Kevin-Pal/ECG-Based-Portable-Heart-Rate-Measurement-and-Alarm-Device/Design of 1st Stage/ref/心电放大器设计(更新).pdf

1.）心电信号十分微弱，一般幅度在10uV～4mV，典型值为1mV。

## 2.）频率在0.05～100Hz，主要能量集中在0.25～35Hz。

3.）从人体上输出心电信号时，存在较强的共模干扰。（人体等效为高内阻的信号源）

4.）信号具有近场检测的特点，离开人体表微小的距离，就基本上检测不到信号。

# 心电放大器设计

## 心电信号的主要特点：

5.）干扰特别强。干扰既来自生物体内，如肌电干扰、呼吸干扰等；也来自生物体外

，如工频干扰、信号拾取时因不良接地等引入的其他外来串扰等；

# 心电放大器设计

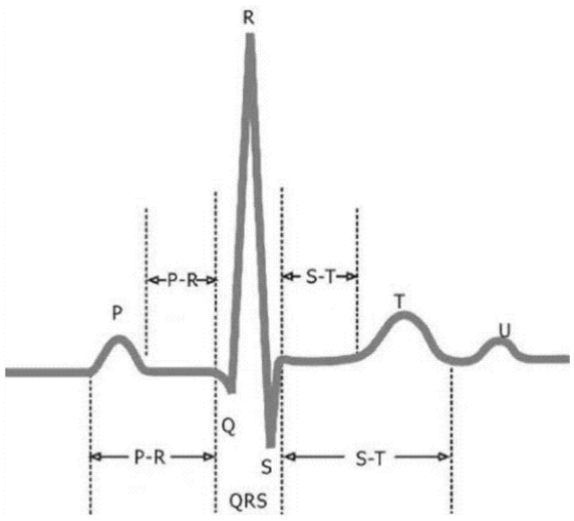
[picture p38: figure]

## 正常的心电信号如图所示：

## 主要的干扰信号

肌电干扰：

肌电干扰主要来源于肌肉活动时，肌肉

细胞的电位变化，一般来源于肌肉的收

缩和颤动，这样的干扰幅值较小，但频
率较高，其频率在5Hz～2000Hz，表现

为不规则快速变化的波形。

# 心电放大器设计

## 主要的干扰信号

工频干扰：

一般还伴随着谐波，在我国使用的市电是50Hz,因此工频干扰也是50Hz的，其谐

波干扰频率一般是50Hz的整数倍。其在时域中表现为整体的极高频，使波形整体图

形模糊，使得信号看起来像是“一整块”，淹没了信号的细节。(一般用均值滤波进

行去噪)

# 心电放大器设计

## 主要的干扰信号

基线漂移：
心电信号的基线漂移主要是由人体呼吸引起的胸廓变化，心电电极的移动引起 ，因为基线漂移与心电信号的ST段较为接近，处理不当，将引起心电信号的ST段信

号失真，造成误诊。常用的去除基线漂移的方法有：小波变换法、中值滤波法、形

态学滤波法、高通滤波法和小波变换法去除基线漂移很有效，但是需要一点的数据

长度，实时性差；中值滤波法在处理基线漂移严重的心电信号时，由于其本身的非 线性特性，容易造成T波变形；高通滤波法选择IIR滤波器时，由于其自身的非线性

相位特性，容易造成波形失真。

# 心电放大器设计

## 设计任务

设计一个心电信号放大电路，能够有效滤除心电信号以外的干扰信号，并能将

微弱的心电信号放大至适合的幅度，以供后续单片机进行集采处理。

## 主要技术指标：

## 1) 输入阻抗： ≥5MΩ 2) 共模抑制比： ≥80dB 3) 通频带： 0.05～100Hz

4）增益：1000倍（放大至单片机可处理范围）

# 心电放大器设计

## 设计指标分析

## 1) 输入阻抗： ≥5MΩ

最好使用JFET输入的运放（输入阻抗极高，输入偏置电流很小，一般为pA-fA级），

使用BJT输入的运放输入阻抗相对小一些，输入偏置电流一般为nA级）

输入端最好构成同向放大器或同向跟随器。

## 可选择的运放：OP07、LF353、TL084、LM358

OP07为BJT输入（一个芯片集成一个运放），输入阻抗： 8M欧-33M欧

工作电压范围：±3V-±18V，也可单电源供电（输入端需要添加参考偏置电压）。

属于精密运放，失调电压小（温漂小），典型值25uV。共模抑制比大于100dB。

# 心电放大器设计

## 设计指标分析

## 1) 输入阻抗： ≥5MΩ

## OP07属于精密运放，输入端噪声相对小。3.5uVp-p(0.1Hz-10Hz)

带宽增益积：500-600KHz 相对较小

压摆率：0.17V/us | 相对较小

适合用作直流，音频等低频小信号精密放大。不能用作高频信号的放大。

适合构成三运放仪表放大器电路、作为前置放大器和有源滤波器！

# 心电放大器设计

## 设计指标分析

## 1) 输入阻抗： ≥5MΩ

LF353属于通用运放（一个芯片集成两个运放），为JFET输入。

输入阻抗很高：1000G欧，失调电压大（温漂大），典型值5mV。

工作电压范围：±5V-±15V，输入噪声比OP07大。

带宽增益积：3-4MHz

## 压摆率：13V/us

适合普通场合的直流，音频等低频小信号放大。可用作中频放大，不能用作高

频信号的放大。适合作为中间级放大器和大信号的有源滤波器！

# 心电放大器设计

## 设计指标分析

## 1) 输入阻抗： ≥5MΩ

TL084属于通用运放（一个芯片集成四个运放），为JFET输入。

输入阻抗很高：1000G欧，失调电压大（温漂大），典型值3mV。

工作电压范围：±3V-±18V，输入噪声比OP07大，比LF353略小。

带宽增益积：3-4MHz

## 压摆率：16V/us

适合普通场合的直流，音频等低频小信号放大。可用作中频放大，不能用作高

频信号的放大。适合作为中间级放大器和大信号的有源滤波器！

# 心电放大器设计

## 设计指标分析

## 1) 输入阻抗： ≥5MΩ

LM358属于通用运放（一个芯片集成两个运放），为BJT输入。

输入阻抗：大约20M欧，失调电压大（温漂大），典型值3mV。

工作电压范围：单电源3V-30V，也可以双电源供电。

输入噪声比OP07大，比LF353略小。

带宽增益积：1MHz

## 压摆率：0.3V/us

适合普通场合的直流，音频等低频小信号放大。不能用作高频信号的放大。

适合作为中间级放大器，比较器和大信号的有源滤波器！

# 心电放大器设计

## 设计指标分析

## 2) 共模抑制比： ≥80dB

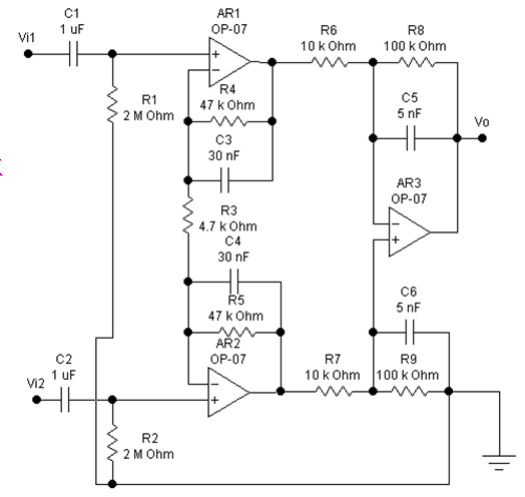
[picture p39: figure]

关键是提高差模增益，降低共模增益，

前级采用仪表放大器（三运放电路）

的结构。
电路中的RC元件尽量对称。

三运放仪器放大器电路如图所示。

电路图中的电容主要作用：构成低通

滤波器。

三运放仪器放大器电路原理图

# 心电放大器设计

## 设计指标分析

## 2) 共模抑制比： ≥80dB

该电路输入电阻大，约为2MΩ，通频带约为（0.2Hz,100Hz），由于高输入阻

抗，电路容易引入50Hz 共模干扰，所以应使电路具有较大CMRR（电路的共模放大

倍数尽可能 小） 电阻R9改为91kΩ固定电阻与20kΩ可变电阻的串联，用于调整，使

电路的共模电压放大倍数尽可能小。
为了使电路的共模电压放大倍数尽可能小，输入端的电容C1、C2和电阻R1、

R2应尽可能一致。

# 心电放大器设计

## 设计指标分析

## 2) 共模抑制比： ≥80dB

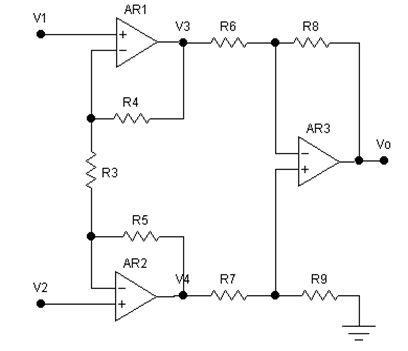
[picture p40: figure]

简化的三运放仪器放大器电路原理图

电路中运放的选择：

## OP07、LF353、TL084、LM358

考虑性能指标哪个更合适？
考虑电路成本和PCB设计布线，哪个比较合适？

# 心电放大器设计

## 设计指标分析

## 2) 共模抑制比： ≥80dB

差模电压增益的计算：

对于AR2，AR1输入端“虚短”

，VNAR1≈V1，VNAR1为AR1反相输入端电压，

AR2、R3、R5等效为反相输入放大器，所以

假设V1≠0、V2接地(V2=0)时，如简化的电路图，对于运放AR1，AR2输入端“

虚短”

，运放AR1、R3、R4等效为同相输入放大器，所以有：

1
3

4

3 | )V
R
R V = (1+ | 1

3

5

4 | V
R

R V = −

# 心电放大器设计

## 设计指标分析

## 2) 共模抑制比： ≥80dB

差模电压增益的计算：

运放AR3构成差分放大器，

8 | 9 | 8
0 | 3 | 4
6 | 7 | 9 | 6
(1 | ) R | R | R V | V | V
R | RR | R
=− ⋅ + | + | ⋅
+

1
3

4

3 | )V
R
R 将 V = (1+ | 代入

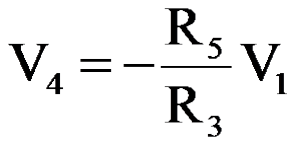
[picture p41: figure]

8 | 4 | 9 | 8 | 5
01 | 1 | 1
6 | 3 | 7 | 9 | 6 | 3
(1 | ) | (1 | ) R | R | R | R R V | V | V
R | R | RR | R | R
=− ⋅ + | + | + | ⋅−
+

将电路图中的电阻数值代入后，可计算出差模电压增益为-210倍。

# 心电放大器设计

## 设计指标分析

## 2) 共模抑制比： ≥80dB

共模电压增益的计算：

同理可得当V1=0、V2≠0时，由V2引起的输出为：

2
3

5

6

6 | 8
7 | 9

9
2
3

4

6

8

o 2 | )V
R

R (1
R

R R
R R

R V
R

R
R
R V | +
+
+
= | +

当电路的输入为共模电压时，有V1=V2=VC，其中VC为共模电压，利用叠加原理，

输出为
C
6 | 7 | 9
6 9 | 7 8
o | o1 | o2 | V

## R (R R )

## R R R R V V V

+

− = | + | =

# 心电放大器设计

## 设计指标分析

## 2) 共模抑制比： ≥80dB

共模电压增益的计算：

电路的共模电压放大倍数为：

## R (R R )

## R R R R

V

V A

6 | 7 | 9
6 9 | 7 8

C

o
VC | +
− = | =

可见，共模电压放大倍数仅与R6、R7、R8、R9有关。若R6R9=R7R8，则共模

电压放大倍数为零。

是否有可能将AVC调得十分接近零呢？

# 心电放大器设计

## 设计指标分析

## 2) 共模抑制比： ≥80dB

灵敏度的计算：

根据以下共模电压放大倍数的灵敏度分析可知，这是十分困难的。

定义电路参数的相对变化率与电路元件值的相对变化率之比为电路参数的灵敏度 。例如，对于本例，共模电压放大倍数AVC关于电阻R6的灵敏度为:

6 9 7 8

7 8

6

V | C
V | C

6

6 | 6
A | vc V | C V | C
R6 | R R R R

R R
dR

dA
A

R

## dRR

dAA S | − = | = | =
7 | 9
6 | 8
6 9 | 7 8

7 9

7

V | C
V | C

7

7 | 7
A | v | cV | CV | C
R7 | R R

R R

## R R R R

R R
d | R
d | A
A

R
d | RR
d | AA S
+

+
−
同样，有 | = | = | = −

# 心电放大器设计

## 设计指标分析

## 2) 共模抑制比： ≥80dB

灵敏度的计算：

因为在设计中要求R6=R7、R8=R9，在实际电路中有R6≈R7、R8≈R9，所以

6 9 7 8

7 9

7

V | C
V | C

7

7 | 7
A | vc V | C V | C
R7 | R R R R

R R
dR

dA
A

R

## dRR

dAA S | − = | = | ≈ −

同理有

6 9 7 8

7 8

8

V | C
V | C

8

8 | 8
A | vc V | C V | C
R8 | R R R R

R R
dR

dA
A

R

## dRR

dAA S | − = | = | = −
6 9 | 7 8

7 9

9

V | C
V | C

9

9 | 9
A | vc V | C V | C
R9 | R R R R

R R
dR

dA
A

R

## dRR

dAA S | − = | = | ≈

# 心电放大器设计

## 设计指标分析

## 2) 共模抑制比： ≥80dB

灵敏度的计算：

这说明，当R6R9 →R7R8时，共模电压放大倍数的灵敏度将趋向无穷大，实际

电路中R6和R7 、R8和R9不可能完全相等，当R6R9 →R7R8时，R6和R7 、R8和R9之

间微小差异，将使共模电压放大倍数AVC发生较大的变化，所以，实际电路的AVC不

会等于零。

# 心电放大器设计

## 设计指标分析

## 2) 共模抑制比： ≥80dB

上述分析还说明，若用一个可变电阻，通过调整可变电阻使实际电路的AVC尽

可能小，则可用可变电阻替代R6、R7 、R8和R9中的任一电阻。本实验电路建议用

可变电阻替代R9。

在用可变电阻替代R9后，对于上图所示的电路，要使共模增益AVC尽可能小，

就应使C1与C2、C3与C4、C5与C6、R1与R2、R6与R7尽可能相等。

# 心电放大器设计

## 设计指标分析

## 2) 共模抑制比： ≥80dB

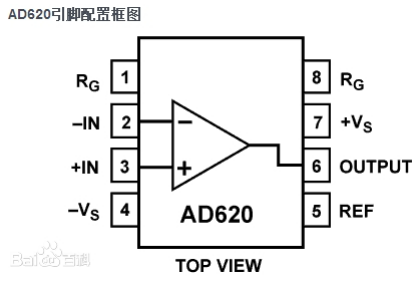
[picture p42: figure]

常用的仪表放大器芯片（集成的三运放电路）

## AD620、INA333、INA128、 INA129等

特点：1.）内部电阻激光工艺匹配精度高，有较高的共模抑制比。

2.）直流精度高，低失调电压(最大50 μV)和低失调漂移。

3.）使用方便，外围元件少，只有一个外部电阻设置总增益。

4. ）可设置输出直流电平。（REF端口）

5.）工作频率相对较低，工作频率升高到一定程度后，共模抑制比明显下降。

# 心电放大器设计

## 设计指标分析

## 2) 共模抑制比： ≥80dB

常用的仪表放大器芯片AD620

AD620具有高精度(最大非线性度40 ppm)、低失调电压(最大50 μV)和低失调漂

移(最大0.6 μV/°C)特性，是电子秤和传感器接口等精密数据采集系统的理想之选。

它还具有低噪声、低输入偏置电流和低功耗特性，使之非常适合ECG和无创血压监

测仪等医疗应用。

其输入级采用Superβeta处理，因此可以实现最大1.0 nA的低输入偏置电流。

## AD620在1 kHz时具有9 nV/√Hz的低输入电压噪声，在0.1 Hz至10 Hz频带内的噪声峰

峰值为0.28μV，输入电流噪声为0.1 pA/ √Hz，因而作为前置放大器使用效果很好。

# 心电放大器设计

## 设计指标分析

## 2) 共模抑制比： ≥80dB

常用的仪表放大器芯片AD620

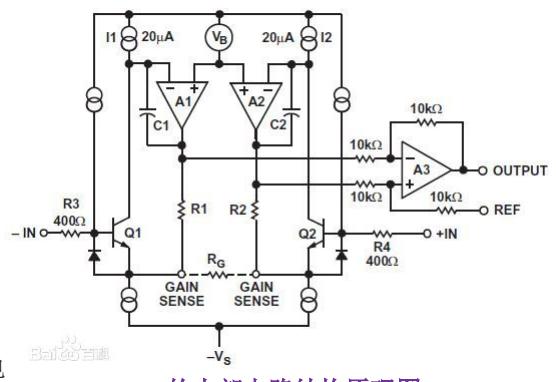
[picture p43: figure]

AD620的内部电路结构原理图

AD620 由传统的三运算放大器发

展而成, 但一些主要性能却优于三

运算放大器构成的仪表放大器。
如电源范围宽(±2. 3～ ±18 V ) ,

设计体积小, 功耗非常低(最大供电

电流仅1. 3 mA ) , 因而适用于低电

压、低功耗的应用场合。

# 心电放大器设计

## 设计指标分析

## 2) 共模抑制比： ≥80dB

常用的仪表放大器芯片AD620

AD620 的单片结构和激光晶体调整, 允许电路元件紧密匹配, 从而保证电路固

有的高性能。AD620 为保护增益控制的高精度, 其输入端的三极管提供简单的差分

双极输入, 并采用β工艺获得更低的输入偏置电流, 通过输入级内部运放的反馈, 保

持输入三极管的集电极电流恒定, 并使输入电压加到外部增益控制电阻 | 上。
AD620 的两个内部增益电阻 | 为24. 7 KΩ , 总增益方程式为：
2 | 49.4 1 | 1 F
G | G

R
G
R | R
=+ | =+

G R

F R

# 心电放大器设计

## 设计指标分析

## 2) 共模抑制比： ≥80dB

常用的仪表放大器芯片AD620的应用： 压力传感器电路

AD620 特别适宜于较高电阻值, 较低电源电压的压力传感器电路设计。左图为3

## .8KΩ、+ 5 V 电源供电的压力传感器电桥。电桥功耗仅为1. 7 mA ,AD620 和AD705

缓冲电压驱动器对信号调节,使总供电电流仅为3. 8 mA , 同时该电路产生的噪声和漂

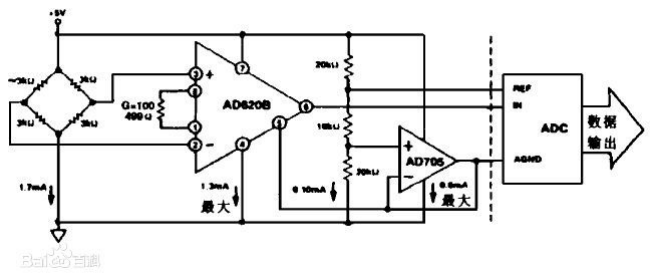
[picture p44: figure]

移也极低。

# 心电放大器设计

## 设计指标分析

## 2) 共模抑制比： ≥80dB

常用的仪表放大器芯片AD620的应用： 心电图监测电路

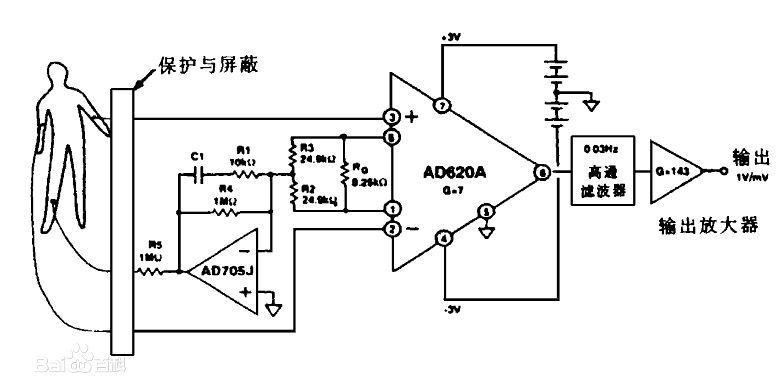
[picture p45: figure]

在心电图监测电路设计中, 信号的源阻抗

极高、器件要求具有便携特点, 这就要求

用低功耗、低供电电压的放大器进行设计
。左图为心电图监测电路中AD620 的应用

。AD620 的低电压噪声改善了动态范围,

使监测电路具有较好的性能, 为了维持图

中驱动环路的稳定性, 应使电容C1 值选择

适当的值。

# 心电放大器设计

## 设计指标分析

## 2) 共模抑制比： ≥80dB

常用的仪表放大器芯片AD620的应用： 精密电压电流转换器

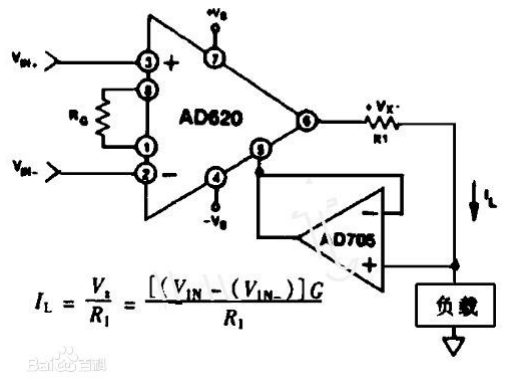
[picture p46: figure]

AD620 与一运放组合可以设计成一个精密电

压电流转换器，通过AD705 对AD620 的参考

端进行缓冲, 使之保持优秀的跟踪性能。

# 心电放大器设计

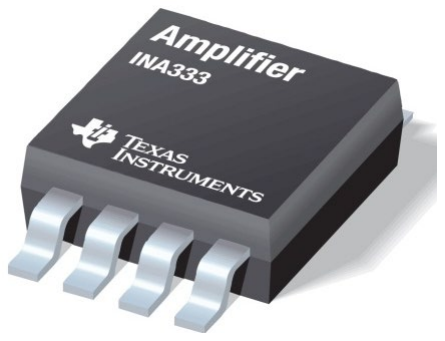
[picture p47: figure]

## 设计指标分析

## 2) 共模抑制比： ≥80dB

常用的仪表放大器芯片INA333

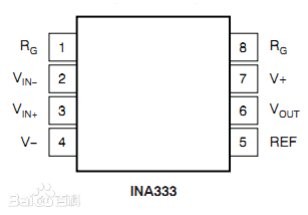
[picture p48: figure]

## 输入失调电压: 25uV (max), G ≥ 100 零点漂移: 0.1 u V/ ° C, G ≥ 100 共模抑制比: 100dB (min), G ≥ 10 输入偏置电流: 200pA (max) 输入电压范围: (V – ) +0.1V to (V+) – 0.1V 输出电压范围: (V – ) +0.05V to (V+) – 0.05V 电源范围：1.8V 至 5.5V

低静态电流：50μA

## 低噪声：50 n V / √ H z ，G ≥ 100

# 心电放大器设计

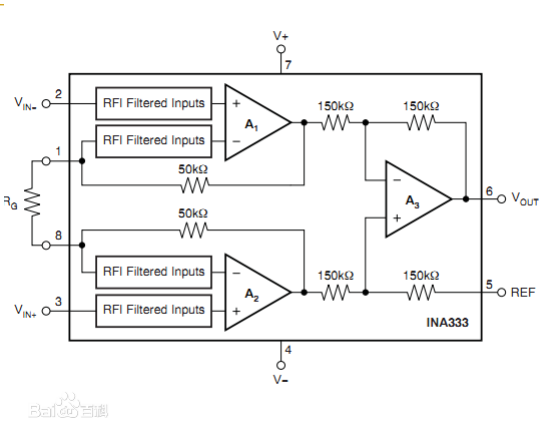
[picture p49: figure]

## 设计指标分析

## 2) 共模抑制比： ≥80dB

常用的仪表放大器芯片INA333

INA333 器件是一款低功耗的精密仪表放大

器，具有出色的精度。该器件采用通用的三

运算放大器设计，并且拥有小巧尺寸和低功

耗特性，非常适合各类便携式 应用。可通
过单个外部电阻在 1 到 1000 范围内设置增

益。INA333 设计为采用符合行业标准的增
益公式： | 2
1 | F
| G

R
G
R

= +

# 心电放大器设计

## 设计指标分析

## 2) 共模抑制比： ≥80dB

常用的仪表放大器芯片INA333

应用范围：
桥式放大器
心电图 (ECG) 放大器
压力传感器
医疗仪表
便携式仪表
衡器
热电偶放大器

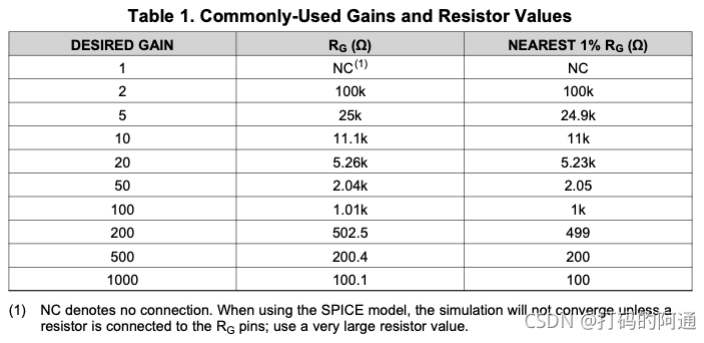
[picture p50: figure]

电阻式温度检测器 (RTD) 传感器放大器
数据采集

# 心电放大器设计

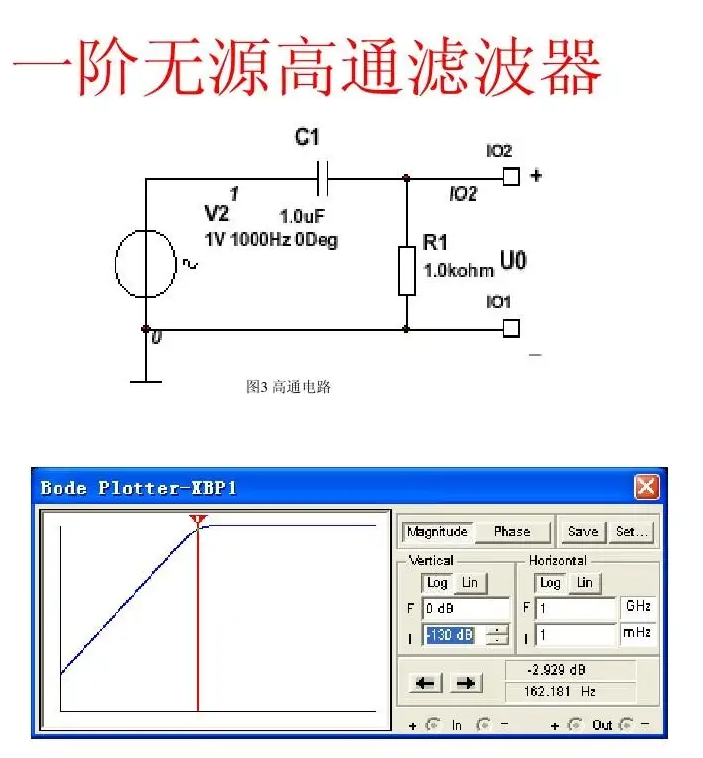
[picture p51: figure]

## 设计指标分析

## 3) 通频带： 0.05～100Hz

电路中采用高通滤波器和低通滤波器

来限制通频带。

高通滤波器可使用无源滤波器：

11

1
2 L f
π RC

=

# 心电放大器设计

## 设计指标分析

## 3) 通频带： 0.05～100Hz

低通滤波器可使用有源滤波器，可以使用MFB或者Sallen_Key结构的有源

滤波器（2阶或者更高阶），也可以在放大器的反馈电阻上并联电容构成简

单的1阶低通滤波器。

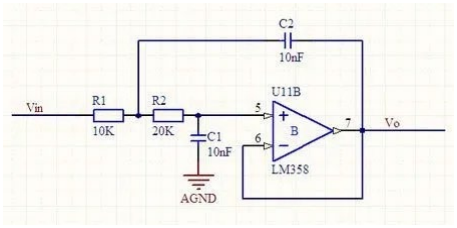
[picture p52: figure]
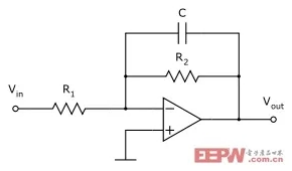
[picture p53: figure]

1阶简单的有源低通滤波器 | Sallen_Key2阶有源低通滤波器

# 心电放大器设计

## 设计指标分析

## 3) 通频带： 0.05～100Hz

2阶基本节MFB滤波器（最少5个外围RC元件）比2阶Sallen_Key基本节滤

波器（最少4个外围RC元件）多一个外围元件，有更低的元件灵敏度，电路更

加稳定，没有高频馈通现象。
2阶Sallen_Key基本节滤波器电路更简单，RC元件参数值的计算方便，可

独立调整通带内的增益和截止频率。

在本次设计的心电放大器中，两种滤波器都可以用。

# 心电放大器设计

## 设计指标分析

## 3) 通频带： 0.05～100Hz

有源RC滤波器的优点：

可以充分利用运放的高开环增益，输入阻抗高，输出阻抗低的优点，滤波器效果

理想，通带内有增益，并且增益可以通过外部电阻进行调节，容易实现滤波器和前后级

电路之间的阻抗匹配。（滤波器工作在低频和中频区）

可借助软件进行滤波器参数的设计，推荐软件：Webench , FilterPro等。

选定使用的运放后，电阻取值范围可以几百欧姆-几十K欧姆（注意小电阻要谨慎使

用，电阻也不要取太大（M欧姆级）），电容取值范围pF-nF级，（电容太大和太小

都不好，注意小电容要谨慎使用，尽量不要使用电解电容），

# 心电放大器设计

## 设计指标分析

## 3) 通频带： 0.05～100Hz

有源RC滤波器的缺点：

（一）带通滤波器Q值较高时，时域上阶跃响应的过冲较大，容易出现不稳定和自激现象

，导致中心频率偏移，谐振曲线出现畸变。

（二）低通和高通滤波器Q值大于0.707时，幅频特性曲线在靠近截至频率处时，会产生

过冲， Q值越大，过冲越大。

（三）受运放供电电源的影响，电源上的噪声会影响输出信号，因此

一般只能做大信号滤波（几十mV以上的信号），不适合小信号滤波。 （四）工作频率受到运放带宽增益积的限制。（一般小于300KHz）

# 心电放大器设计

## 设计指标分析

4）增益：1000倍（放大至单片机可处理范围）

多级放大满足增益条件，合理的配置各级放大器的增益。
前置放大器（仪表放大器）增益不宜过高，一般10倍左右。

高输入阻抗；高共模抑制比；低噪声、低漂移、非线性度小；合适的频

带和动态范围 ，噪声系数小且具有调节方便的特点。

前级增益过高将不利于后续电路对噪声的处理。

本次设计使用三运放电路构成仪表放大器！（建议选择精密运放）

# 心电放大器设计

## 设计指标分析

4）增益：1000倍（放大至单片机可处理范围）

多级放大满足增益条件，合理的配置各级放大器的增益。
中间级放大器可设置固定10倍增益，建议选择精密运放。

可选择反相放大器，输入阻抗相对较低，输入噪声小。（注意前级电路

的输出阻抗）
后级放大器可设置5-20倍增益可调。选择精密运放和通用运放都可以。

可选择同相放大器，输入阻抗相对较高。

# 心电放大器设计

## 心电放大器的结构

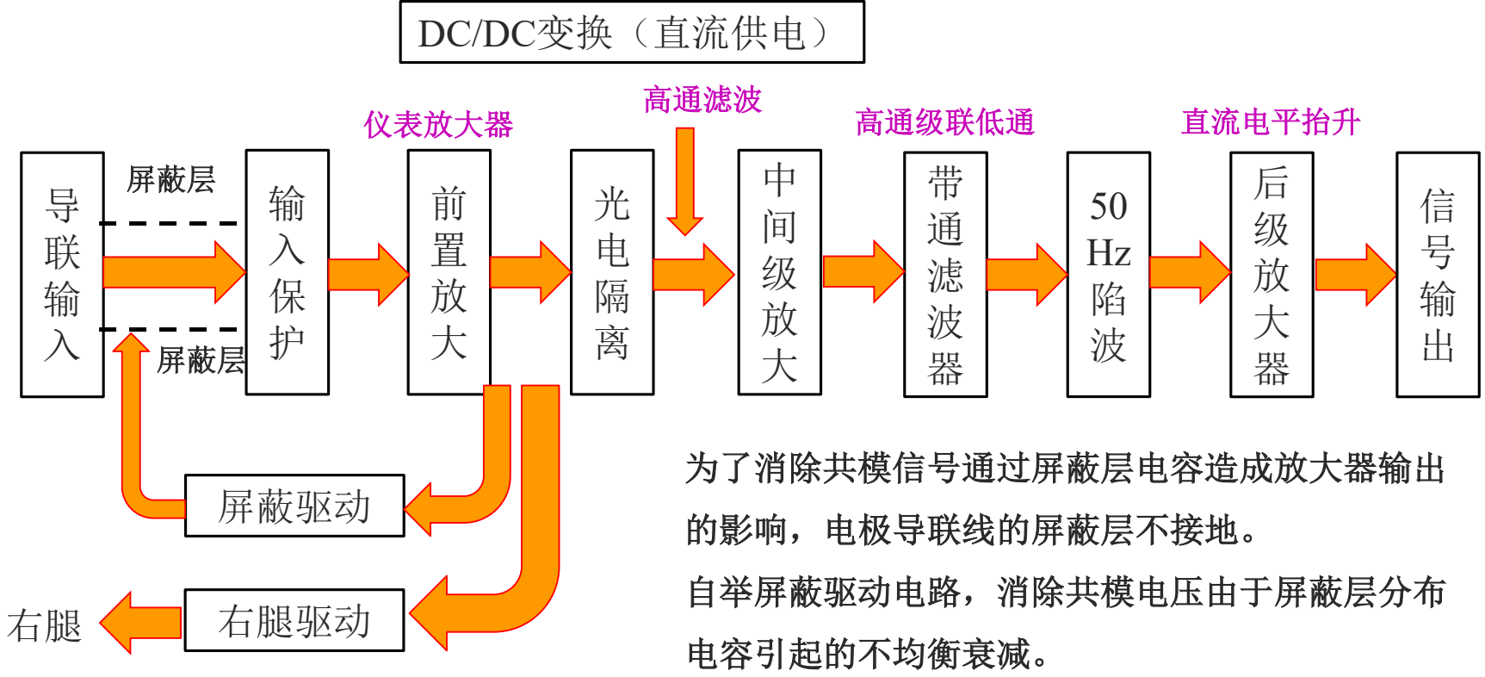
[picture p54: figure]
DC/DC变换（直流供电）; 仪表放大器; 高通级联低通; 屏蔽驱动; 直流电平抬升; 右腿驱动; 屏蔽层; 为了消除共模信号通过屏蔽层电容造成放大器输出; 的影响，电极导联线的屏蔽层不接地。; 自举屏蔽驱动电路，消除共模电压由于屏蔽层分布; 电容引起的不均衡衰减。; 高通滤波

# 心电放大器设计

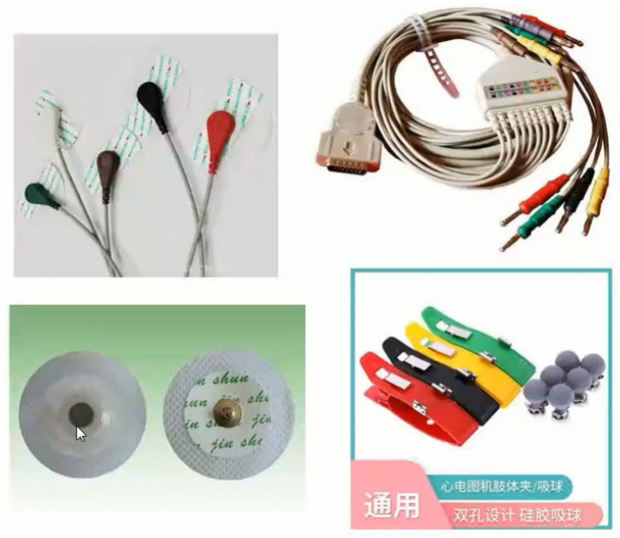
[picture p55: figure]

导联输入

## 心电放大器的结构

将人体中的心电信号耦合

到心电放大器电路中。

# 心电放大器设计

## 心电放大器的结构

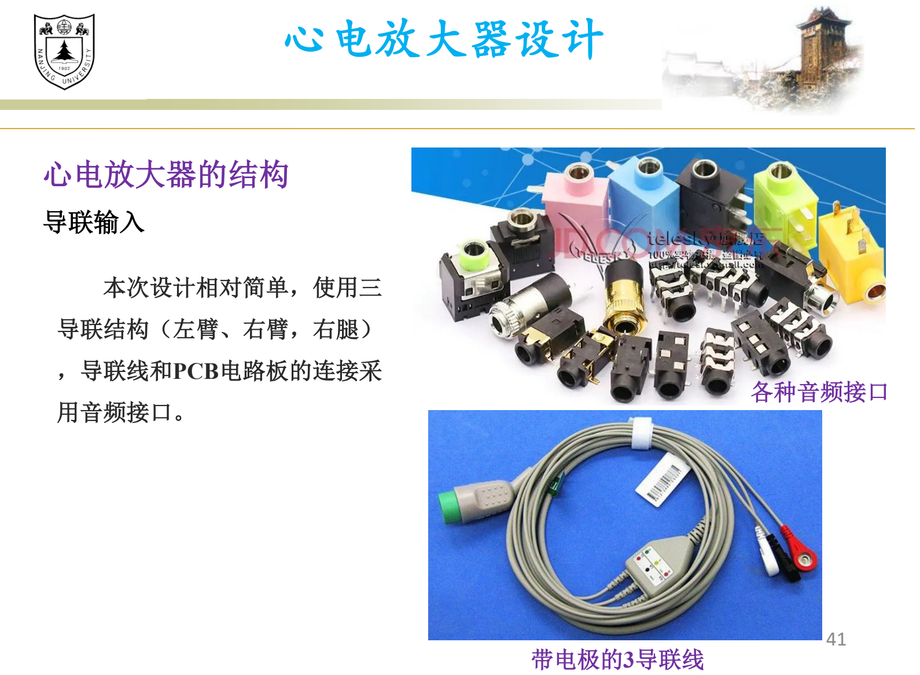
[picture p56: page 41]

导联输入

本次设计相对简单，使用三

导联结构（左臂、右臂，右腿）
，导联线和PCB电路板的连接采

用音频接口。

带电极的3导联线

各种音频接口

# 心电放大器设计

保护电路和屏蔽

## 心电放大器的结构

防止干扰信号输入（大信号电压和电流）使后级放大器饱和，阻塞后级

电路，甚至损坏后级电路。消除地线中的干扰电流，保护人体安全。

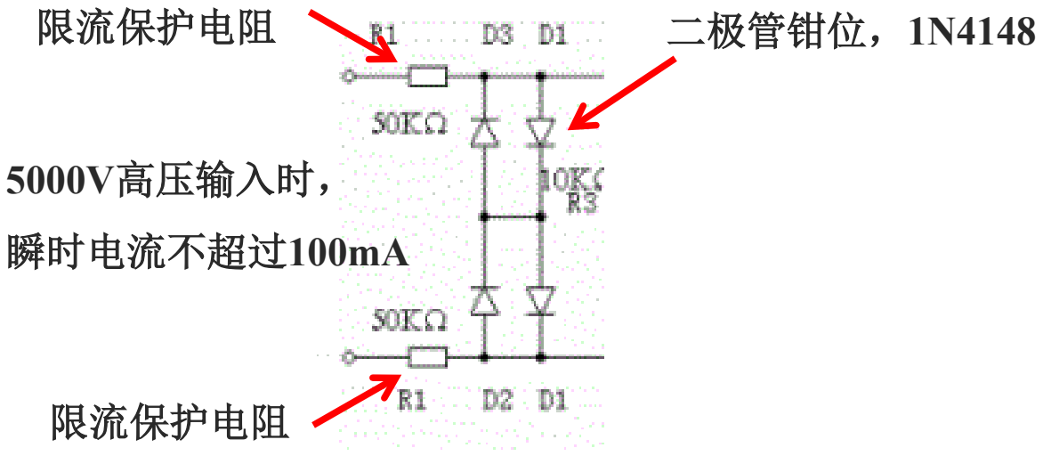
[picture p57: figure]
限流保护电阻; 二极管钳位，1N4148; 5000V高压输入时，; 瞬时电流不超过100mA

限流保护电阻

# 心电放大器设计

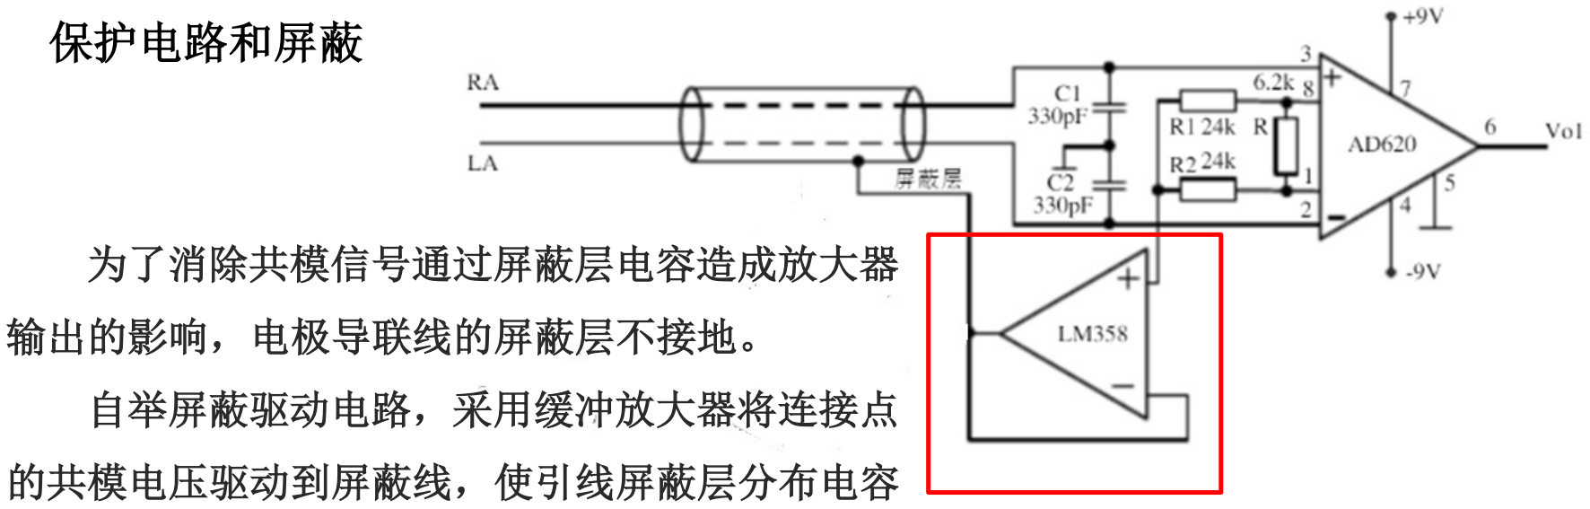
[picture p58: figure]
为了消除共模信号通过屏蔽层电容造成放大器; 输出的影响，电极导联线的屏蔽层不接地。; 自举屏蔽驱动电路，采用缓冲放大器将连接点; 的共模电压驱动到屏蔽线，使引线屏蔽层分布电容

保护电路和屏蔽

## 心电放大器的结构

的两端电压保持相等，消除共模电压由于屏蔽层分

布电容引起的不均衡衰减。

# 心电放大器设计

右腿驱动电路

## 心电放大器的结构

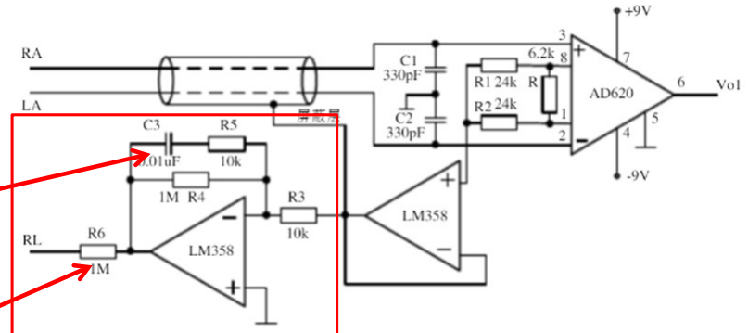
[picture p59: figure]

可以有效的降低共模信号！ | 反相放大，将导联输入中的共模信号反馈到输
| 入端，反相增益越大，对共模信号的抑制就越强！

限流电阻，保护
人体安全

为获得较大增益，
反馈电阻取值较大
，电容C3相位补偿
，提高运放电路的
稳定性。

# 心电放大器设计

右腿驱动电路的工作原理

## 心电放大器的结构

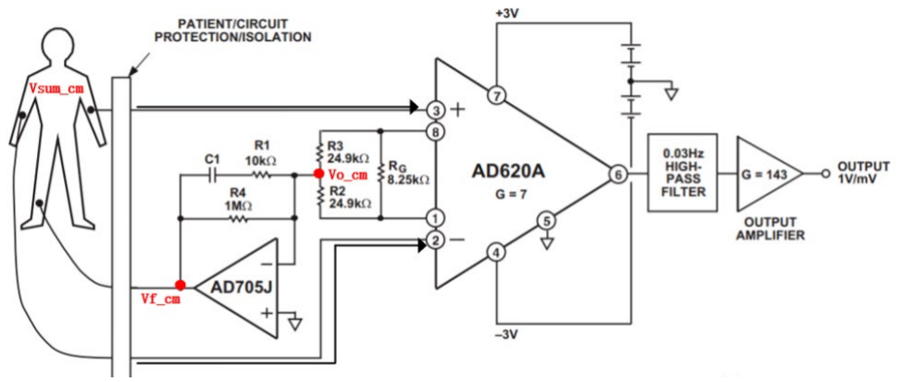
[picture p60: figure]

运放AD705J构成右腿驱动电路，右腿驱动电路的主要作用是提高共模抑制比

，减少50Hz或60Hz的工频干扰。

# 心电放大器设计

右腿驱动电路的工作原理

## 心电放大器的结构

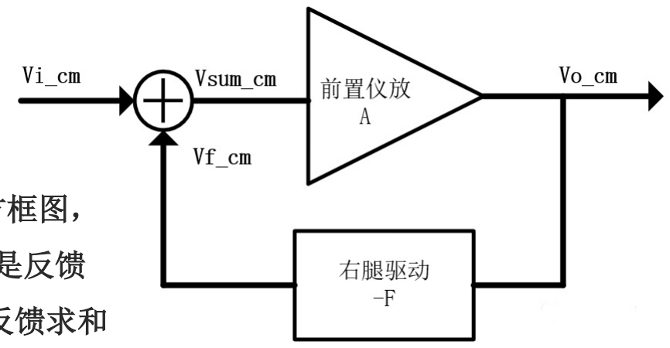
[picture p61: figure]

右腿驱动电路可以简化为如图的方框图，
Vi_cm是输入的共模电压，Vf_cm是反馈

回来的电压，Vsum_cm是输入和反馈求和

后的电压，Vo_cm是输出的电压，前置仪

表放大器对于共模信号而言放大倍数A=1

，右腿驱动电路的放大倍数大约几十倍，

是反向比例放大。

根据上图可以得到系统输入输出关系：

## Vo_cm = Vsum_cm * A = Vsum_cm Vsum_cm = Vi_cm + Vf_cm Vf_cm = -F*Vo_cm 合并上面两个公式： Vo_cm = Vi_cm/ (1 + F)

# 心电放大器设计

右腿驱动电路的工作原理

## 心电放大器的结构

## Vo_cm = Vi_cm/ (1 + F)

由于放大倍数F比较大，因此输入共模电压就被衰减了，Vo_cm会非常小，共

模抑制比是差模增益与共模增益的比值，因此共模抑制比就可以提高。

总结：右腿驱动电路提取出共模电压，对其进行反向放大，再反馈回人体，

人体共模信号叠加这个反向放大的共模信号后就会被抑制。

# 心电放大器设计

前置放大器

## 心电放大器的结构

前置放大器（仪表放大器）增益不宜过高，一般10倍左右。防止电极处产生的极化

直流电压（可能达到300mV），使前置放大器输出饱和。

高输入阻抗；高共模抑制比；低噪声、低漂移、非线性度小；合适的频带和动

态范围 ，噪声系数小且具有调节方便的特点。

前级增益过高也不利于后续电路对噪声的处理。

本次设计前置放大器使用三运放电路构成仪表放大器！（建议选择精密

运放）

# 心电放大器设计

光电隔离

## 心电放大器的结构

在前置放大器和中间级放大器之间使用光耦合器件。（亦称光电隔离器或光

电耦合器，简称光耦）。

光耦器件是以光为媒介来传输电信号的器件，通常把发光器（红外线发光二极 管LED）与受光器（光敏半导体管，光敏电阻等）封装在同一管壳内。当输入端

加电信号时发光器发出光线，受光器接收光线之后就产生光电流，从输出端流出 ，从而实现了“电—光—电”控制。以光为媒介把输入端信号耦合到输出端的光

电耦合器，由于它具有体积小、寿命长、无触点，抗干扰能力强，输出和输入之

间绝缘，单向传输信号等优点，在数字电路上获得广泛的应用。

# 心电放大器设计

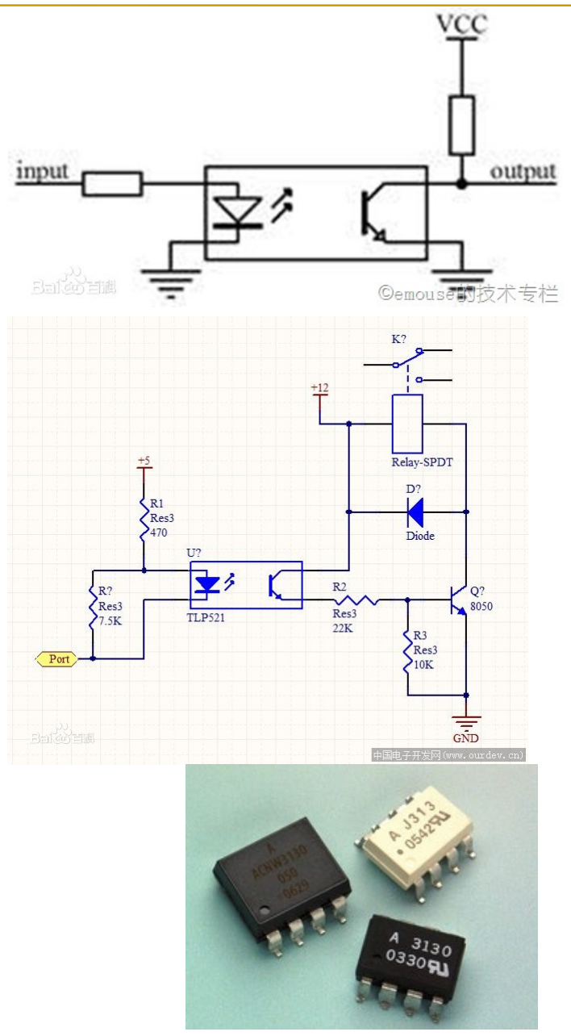
[picture p62: figure]

光电隔离

## 心电放大器的结构

由于光耦合器输入输出间互相隔离，电信号传输

具有单向性等特点，因而具有良好的电绝缘能力和抗

干扰能力。所以，它在长线传输信息中作为终端隔离

元件可以大大提高信噪比。在计算机数字通信及实时

控制中作为信号隔离的接口器件，可以大大提高计算

机工作的可靠性。

光耦合器的输入端属于电流型工作的低阻元件，

因而具有很强的共模抑制能力。

# 心电放大器设计

光电隔离

## 心电放大器的结构

由于光耦合器输入输出间互相隔离，电信号传输具有单向性等特点，因而具有良

好的电绝缘能力和抗干扰能力。所以，它在长线传输信息中作为终端隔离元件可以大

大提高信噪比。在计算机数字通信及实时控制中作为信号隔离的接口器件，可以大大

提高计算机工作的可靠性。

光耦合器的输入端属于电流型工作的低阻元件，因而具有很强的共模抑制能力。

# 心电放大器设计

光电隔离

## 心电放大器的结构

光耦合器的主要优点：

信号单向传输，输入端与输出端完全实现了电气隔离，输出信号对输入端无影响

，抗干扰能力强，工作稳定，无触点，使用寿命长，传输效率高。 光耦合器是70年代发展起来产新型器件，现已广泛用于电气绝缘、电平转换、级

间耦合、驱动电路、开关电路、斩波器、多谐振荡器、信号隔离、级间隔离 、脉冲放 大电路、数字仪表、远距离信号传输、脉冲放大、固态继电器(SSR）、仪器仪表、通

信设备及微机接口中。在单片开关电源中，利用线性光耦合器可构成光耦反馈电路，

通过调节控制端电流来改变占空比，达到精密稳压目的，实现信号接收转移。

# 心电放大器设计

光电隔离

## 心电放大器的结构

光电耦合器分类：

非线性光耦 电流传输特性曲线是非线性的，这类光耦适合于开关信号的传输 ，不适合于传输模拟量。常用的4N系列光耦属于非线性光耦。

线性光耦

电流传输特性曲线接近直线，并且小信号时性能较好，能以线性特性进行隔离 控制。常用的线性光耦是PC817A—C系列。

# 心电放大器设计

光电隔离

## 心电放大器的结构

光电耦合的主要特点：
1.输入和输出端之间绝缘，其绝缘电阻一般都大于10000MΩ，耐压一般可超过1kV

，有的甚至可以达到10kV以上。

2.由于光接收器只能接受光源的信息，反之不能，所以信号从光源单向传输到光接

收器时不会出现反馈现象，其输出信号也不会影响输入端。 3.由于发光器件（砷化镓红外二极管）是阻抗电流驱动性器件，而噪音是一种高内

阻微电流电压信号。因此光电耦合器件的共模抑制比很大，所以，光电耦合器件可

以很好地抑制干扰并消除噪音。

# 心电放大器设计

光电隔离

## 心电放大器的结构

光电耦合的主要特点：
4.容易和逻辑电路配合。

5.响应速度快。光电耦合器件的时间常数通常在毫秒甚至微秒级。

6.无触点、寿命长、体积小、耐冲击。

在心电放大器中使用光耦器件，可实现小信号的单向传输，防止后级放大器的

输出信号和干扰信号影响前级小信号放大。
有时候用微处理器（FPGA器件）驱动控制小功率信号器件（电路）+光电隔离

+驱动大功率器件，保护前端的微处理器和小功率信号器件（电路），防止被反向

的浪涌电压和电流造成损坏。

# 心电放大器设计

中间级放大

## 心电放大器的结构

中间级放大器可设置固定增益（比如10倍左右），建议选择精密运放。

可选择反相放大器，输入阻抗相对较低，输入噪声小。（注意前级电路的输

出阻抗）

# 心电放大器设计

带通滤波器

## 心电放大器的结构

可使用无源高通滤波器+有源低通滤波器串联。

低通滤波器的截止频率选择在100Hz左右，可以使用MFB或者Sallen_Key结构的

有源低通滤波器（一般2阶就可以了，下降速度更快则需要2阶以上）。

滤波器的运放可以选择OP07也可以使用通用运放。

# 心电放大器设计

## 50Hz陷波

## 心电放大器的结构

在心电放大器前端输入和中间耦合的众多噪声中，50Hz的工频干扰尤为严重

，因此在电路设计时可设计50Hz的陷波器，进一步消除工频信号干扰。但由于心

电信号频率在0.05～100Hz，陷波器的加入会使得50Hz及其附近频率处的能量衰

减，心电信号会有一定程度地失真。

# 心电放大器设计

## 50Hz陷波

## 心电放大器的结构

双T网络陷波电路，又称为带阻滤波器，用于抑制或衰减某一频率段的信号

，而该频率段外的所有信号可以通过。典型的RC双T网络，又RC低通滤波器和

RC高通滤波器并联而成。低通滤波器的截止频率为 | ，高通滤波器的截止频率
为 | ，满足条件 | 时构成带阻滤波器。当输入信号通过电路时，频率低于
的信号均可以从低通滤波器通过；频率高于 | 的信号均可以从高通滤波器通过
；频率范围在 | 内的信号被衰减或阻断。

1 f

2 f | 1 | 2 f | f <
1 f | 2 f
1 | 2 f | f | f < | <

# 心电放大器设计

## 50Hz陷波

## 心电放大器的结构

无源双T网络陷波电路，元件参数满足关系：

1 | 2 C | C | C = | = | 3 C | C = 2
1 | 2 R | R | R = | = | 3 R | R = | /2

0

1
RC 带阻中心频率 ω =
品质因数 ⁴ 2
RC β = | 0 | 1
2 | 4
Q | ω
β = | =

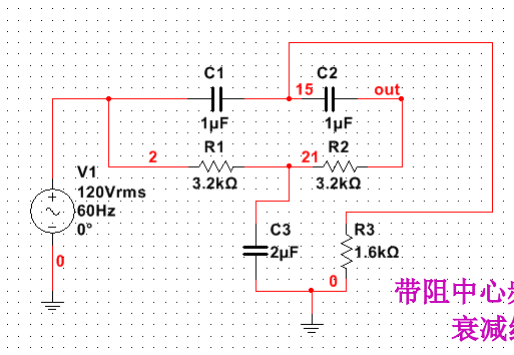
[picture p63: figure]
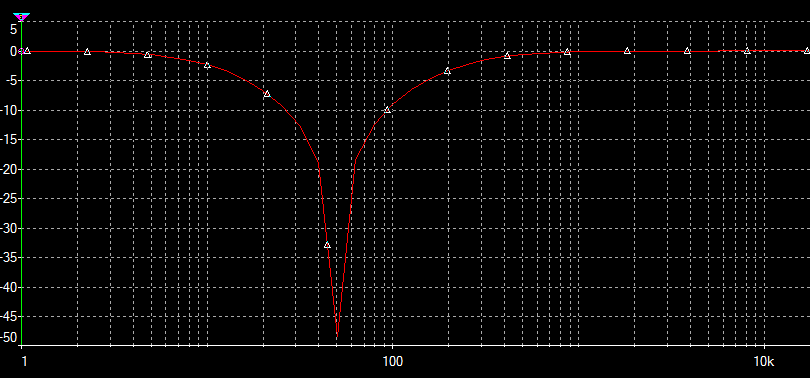
[picture p64: figure]

无源双T网络陷波电路 | 无源双T网络陷波电路的频率响应

带阻中心频率约50Hz

### 衰减约50dB

# 心电放大器设计

## 50Hz陷波

## 心电放大器的结构

无源双T网络陷波电路，输入阻抗较小，输出阻抗较大，容易受到前后级电

路的影响，Q值较低，衰减带宽较宽，对阻带中心频率两侧的信号影响较大。

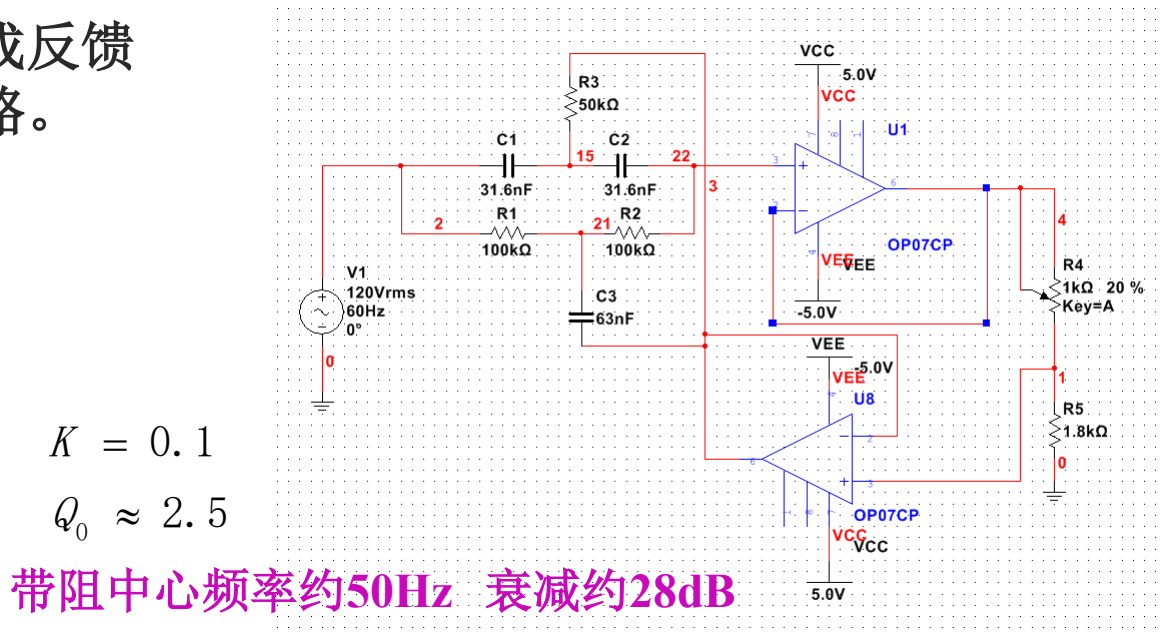
[picture p65: figure]
带阻中心频率约50Hz 衰减约28dB

无源双T网络陷波电路加上运放构成反馈
，组成性能较好的有源双T陷波电路。

有源双T网络陷波电路

0 Q ≈ 2.5

K = 0.1

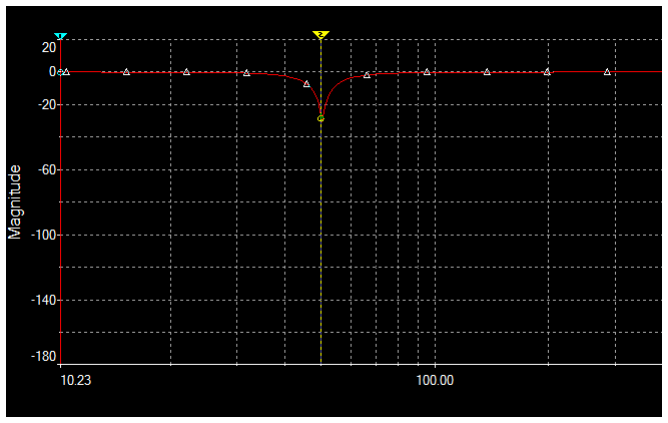
[picture p66: figure]

有源双T网络陷波电路的频率响应

# 心电放大器设计

## 50Hz陷波

## 心电放大器的结构

有源双T网络陷波电路，由两个运放和双T陷波网络组成，引入负反馈改善选

频作用，运放U1提供反馈回路的增益，同时对双T陷波网络起到隔离作用。

两个反馈电阻的 取值， | ， | 系数K决定阻带宽度。K越

大，阻带宽度越窄，品质因素Q值越高，陷波特性越好，但同时使得电路的稳定

性变差；反之， K越小，阻带宽度越宽，品质因素Q值越低，陷波特性越差，电

路的稳定性越好。

4 | (1 | ) F R | KR = | − | 5 | F R | KR =

0

1
2

f

π RC = | 0

1
4(1 | ) Q
K = | − | 设计时要求电阻R远大于RF

仿真时观测到，随着K越大，品质因素Q增加，陷波宽度越窄，但是陷波深度

也变小。因此需要合理的选择K值，在电路稳定性、陷波宽带和陷波深度之间

取得平衡。

# 心电放大器设计

后级放大器

## 心电放大器的结构

对心电信号进行进一步放大，使总增益满足设计要求（1000倍）。后级放

大器可设置5-20倍增益可调。选择精密运放和通用运放都可以。

可选择同相放大器，输入阻抗相对较高。

注意点：在本设计中心电信号最终输出给单片机进行ADC采样后续处理，而单

片机的ADC端口输入电压范围为0-3.3V（单极性） ，因此在设计后级电压放大

器时需合理选择放大倍数。

# 心电放大器设计

后级放大器

## 心电放大器的结构

后级放大器的增益不能太小，否则心电放大器的总增益太小，会使得输入单 片机ADC采样的波形幅度不够，单片机ADC采集数据的误差变大；也不宜过大，

否则会使得输入单片机采样的波形幅度超出单片机的ADC端口输入最大电压3.3V

，造成较大的采样误差，甚至损坏单片机的ADC输入端口。

后级放大器中需要加入电压抬升电路
单片机ADC采样端口的输入电压范围一般为0-3.3V，而心电信号有负电压，

因此需要将心电信号加上直流偏置，转换为电压范围在0-3.3V之间的单极性信号

，最后输出到单片机的ADC采样端口进行后续处理。

# 心电放大器设计

后级放大器

## 心电放大器的结构

电压抬升电路设计
可使用单电源供电的运放（LM358或者OP07用单电源供电），在输入加上

直流偏置电压，使运放电路输出的直流电平在 3.3/2=1.65V的位置。

也可以使用加法器电路，将一路直流偏置电压加到输入端，最后和输入交流

信号一起放大后输出。

# 心电放大器设计

## 心电放大器的结构

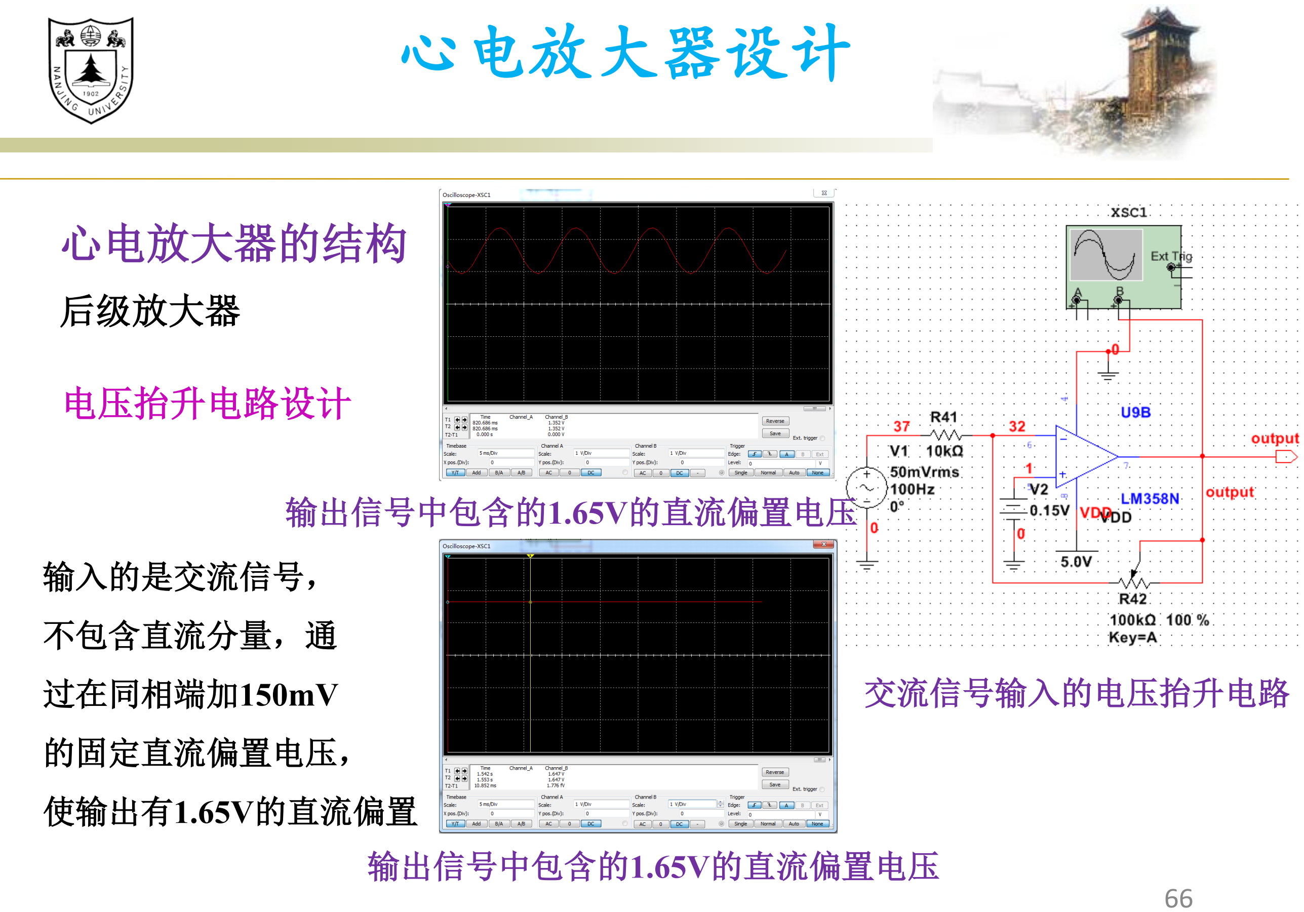
[picture p67: page 66]

后级放大器

电压抬升电路设计

交流信号输入的电压抬升电路

输出信号中包含的1.65V的直流偏置电压

输出信号中包含的1.65V的直流偏置电压

输入的是交流信号，

不包含直流分量，通
过在同相端加150mV

的固定直流偏置电压，
使输出有1.65V的直流偏置

# 心电放大器设计

## 心电放大器的结构

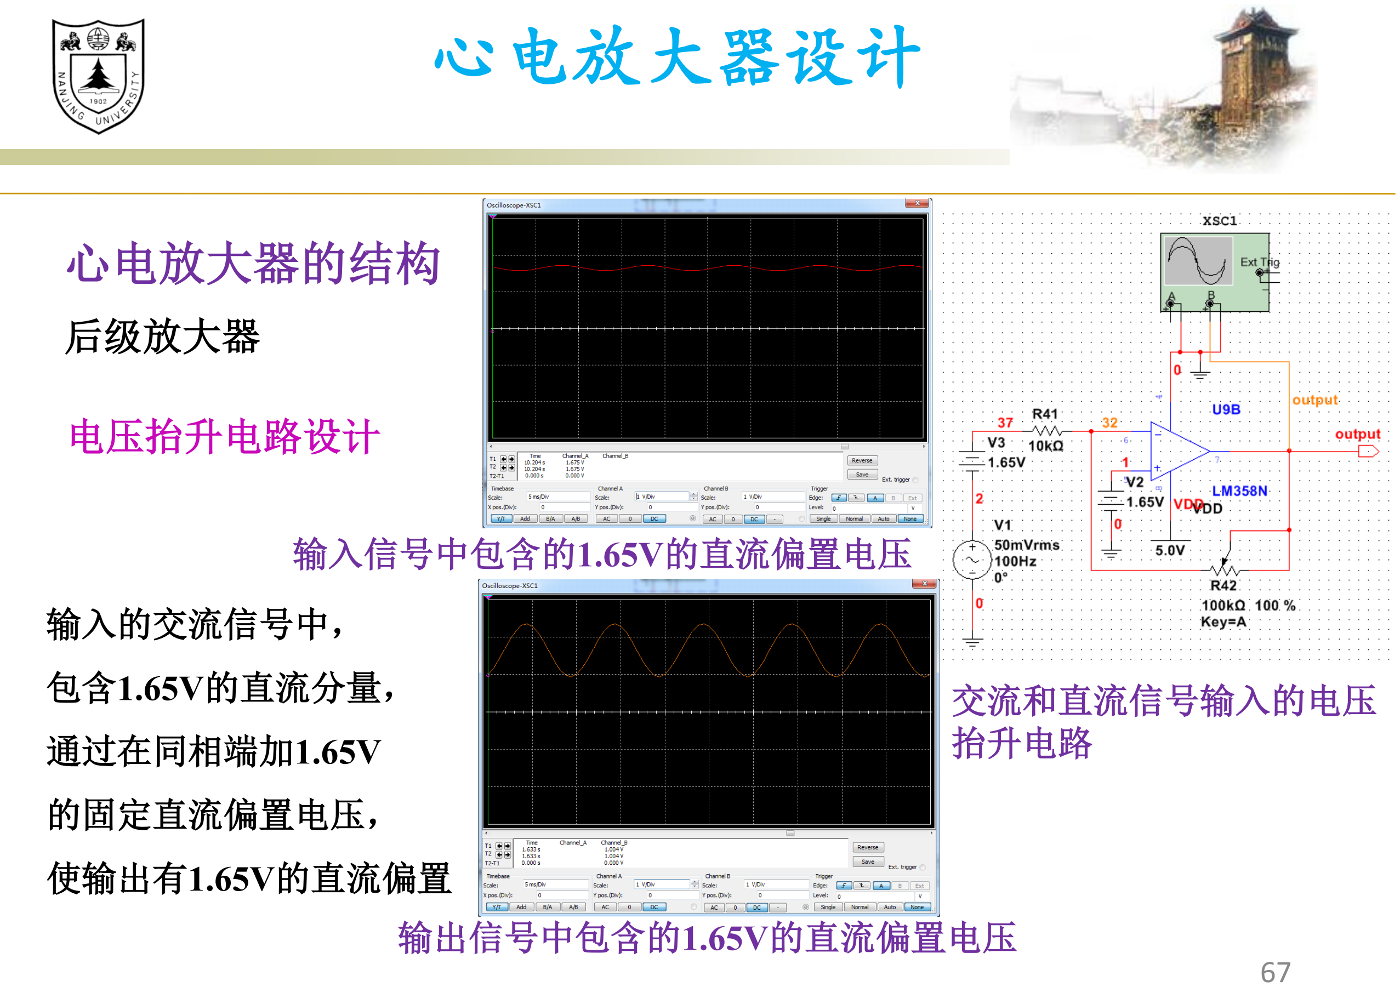
[picture p68: page 67]

后级放大器

电压抬升电路设计

输入信号中包含的1.65V的直流偏置电压

输出信号中包含的1.65V的直流偏置电压

输入的交流信号中，
包含1.65V的直流分量，

通过在同相端加1.65V

的固定直流偏置电压，
使输出有1.65V的直流偏置

交流和直流信号输入的电压
抬升电路

# 心电放大器设计

运放电路可选择双电源供电（电路输入端不需要提供直流偏置，

输出动态范围大）

也可以选择单电源供电 （电路输入端需要提供直流偏置，

输出动态范围小一些，但只需一路正电源）

## 心电放大器的直流电源

电源去耦：在靠近运放的正负电源附近，接0.1uF的无极性电容进行高频去耦（也

可以再并联1个10uF的电解电容进行低频去耦）

在外部的正负直流电源输入端旁边接入10uF的电解电容进行低频去耦。

# 心电放大器设计

有条件的可使用分级去耦的供电方式：

小信号电路和大信号电路的直流电源分级去耦，减小电源馈线上的反馈和

干扰，减小各级电路之间的相互干扰，提高电路输出信号的信噪比，提高电路抗

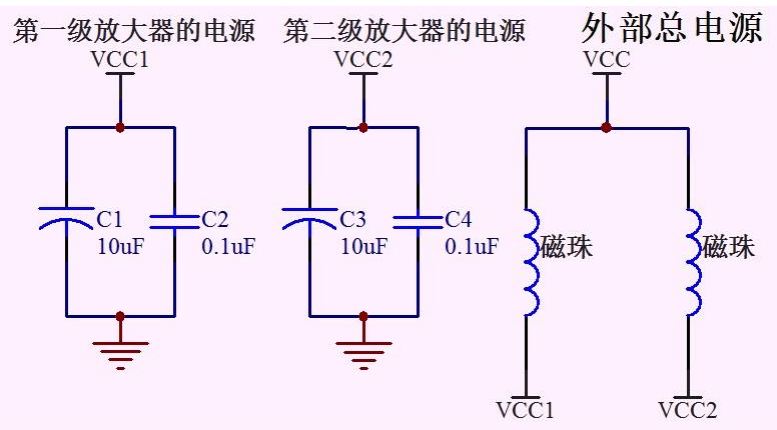
[picture p69: figure]

噪声性能。

## 心电放大器的直流电源

前置放大器的电源
中间级放大器的电源
有源滤波器的电源
后级放大器的电源

可以分级去耦供电
