Kevin-Pal/ECG-Based-Portable-Heart-Rate-Measurement-and-Alarm-Device/Design of 2nd Stage/project/project file/原始数据/IMG_9389.JPG

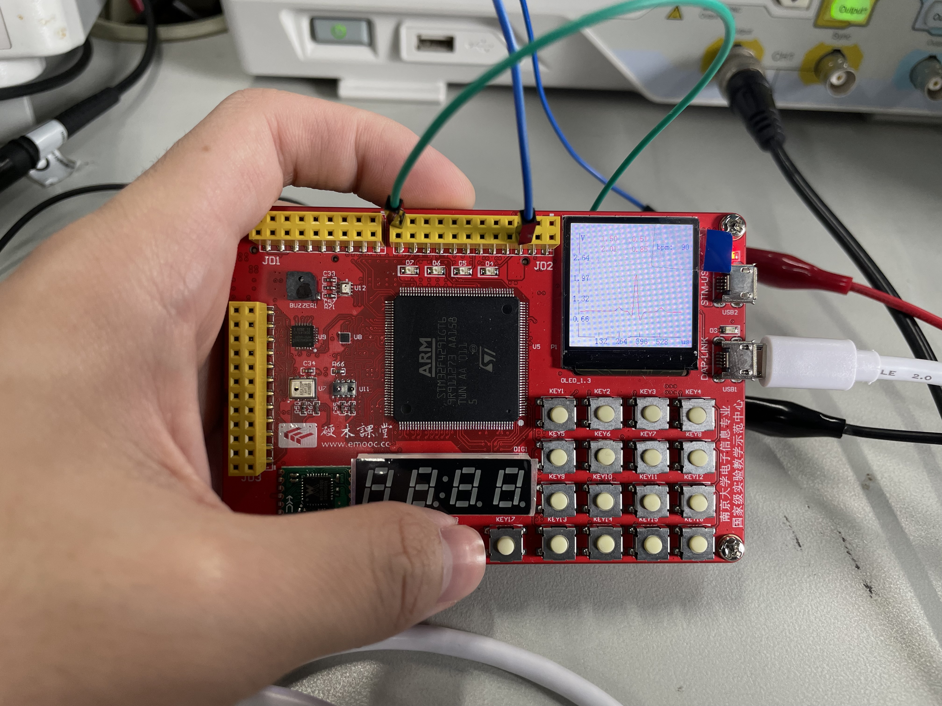
Design of 2nd Stage/project/project file/原始数据/IMG_9389.JPG
