Kevin-Pal/ECG-Based-Portable-Heart-Rate-Measurement-and-Alarm-Device/Design of 1st Stage/ref/实验室提供元器件.xlsx

元器件名称 | 规格 | 备注
常规电阻/电容 | 贴片0805 | 1%误差
常规电阻/电容 | 直插 | 1%误差
精密电阻（误差0.1%） | 贴片0805 | 10K、20K、30K、51K、100K
 | 直插 | 10K、20K、30K、50K、100K
TL084CDR | SOP14 | 四通道14引脚运算放大器（3MHz）
LM358D | SOP8 | 双运算放大器8引脚（1.1MHz）
OP07CDR | SOP8 | 单运算放大器（600KHz）
TL084CN | DIP14 | 四通道14引脚运算放大器（4MHz）
LM358P | DIP8 | 双运算放大器八引脚（1.1MHZ）
LF353P | DIP8 | 双运算放大器八引脚（3MHZ）
OP07CP | DIP8 | 单运算放大器（600KHz）
IC座 | 8脚
 | 14脚
3296电位器 | 直插 | 1K、5K、10K、20K、50K
音频插座 | 贴片/直插
测试环
跳线帽
单排针
 |  | 0
