Kevin-Pal/ECG-Based-Portable-Heart-Rate-Measurement-and-Alarm-Device/Design of 2nd Stage/project/project file/STM32F429-20210111(1).pdf

# AD+DA+SPI+UART+IIC+TIMER

数码管&按键 | WIFI

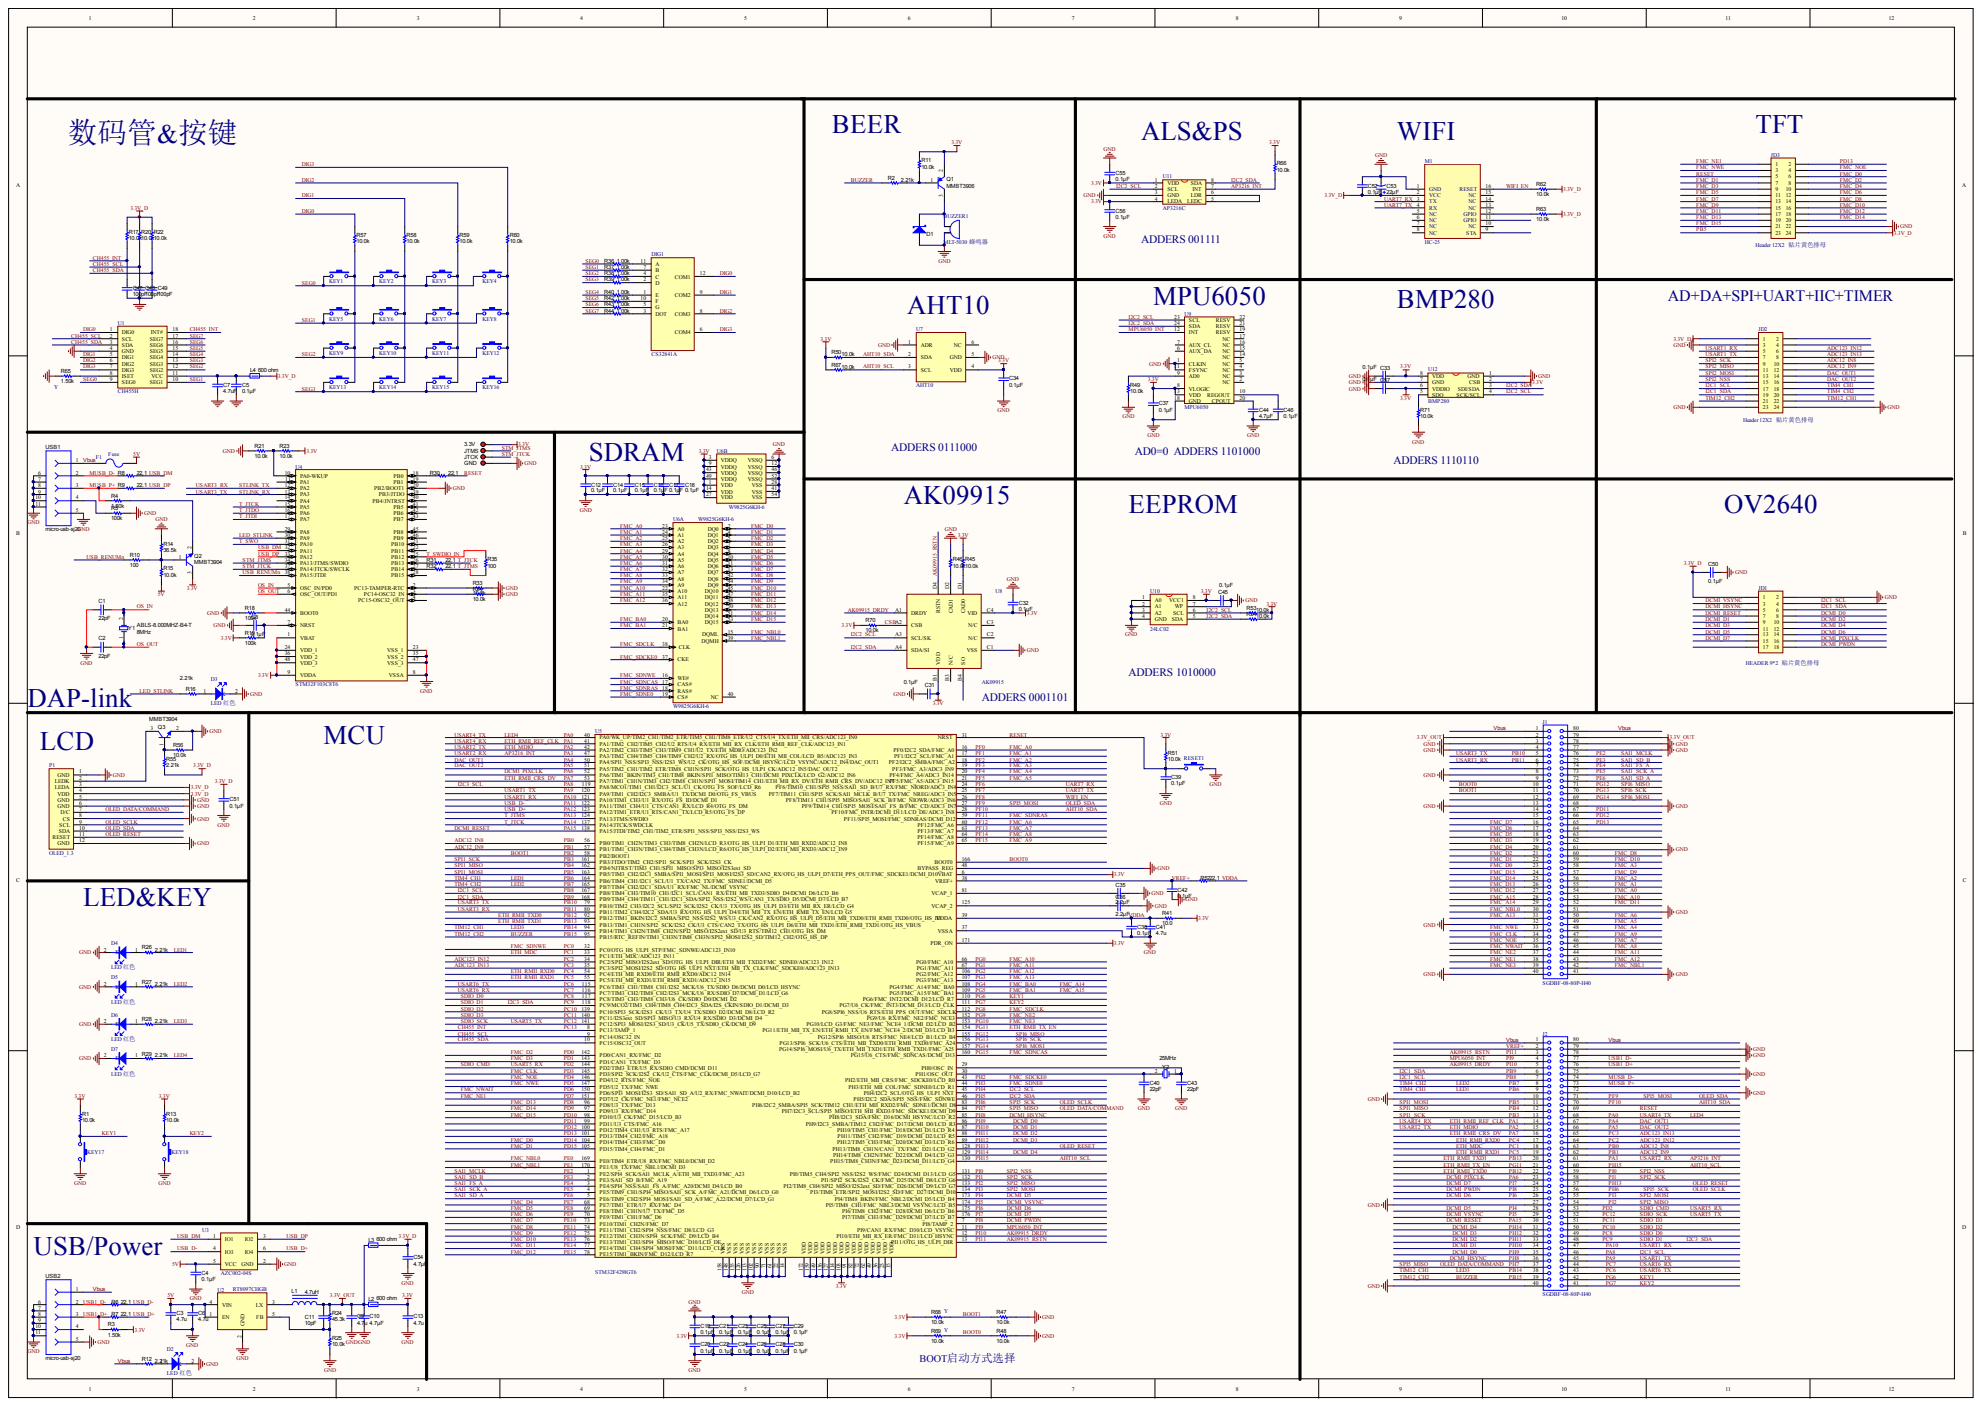
[picture p88: page 1]
