Kevin-Pal/ECG-Based-Portable-Heart-Rate-Measurement-and-Alarm-Device/Design of 2nd Stage/ref/STM32参考资料/4-STM32F429-开发板原理图.pdf

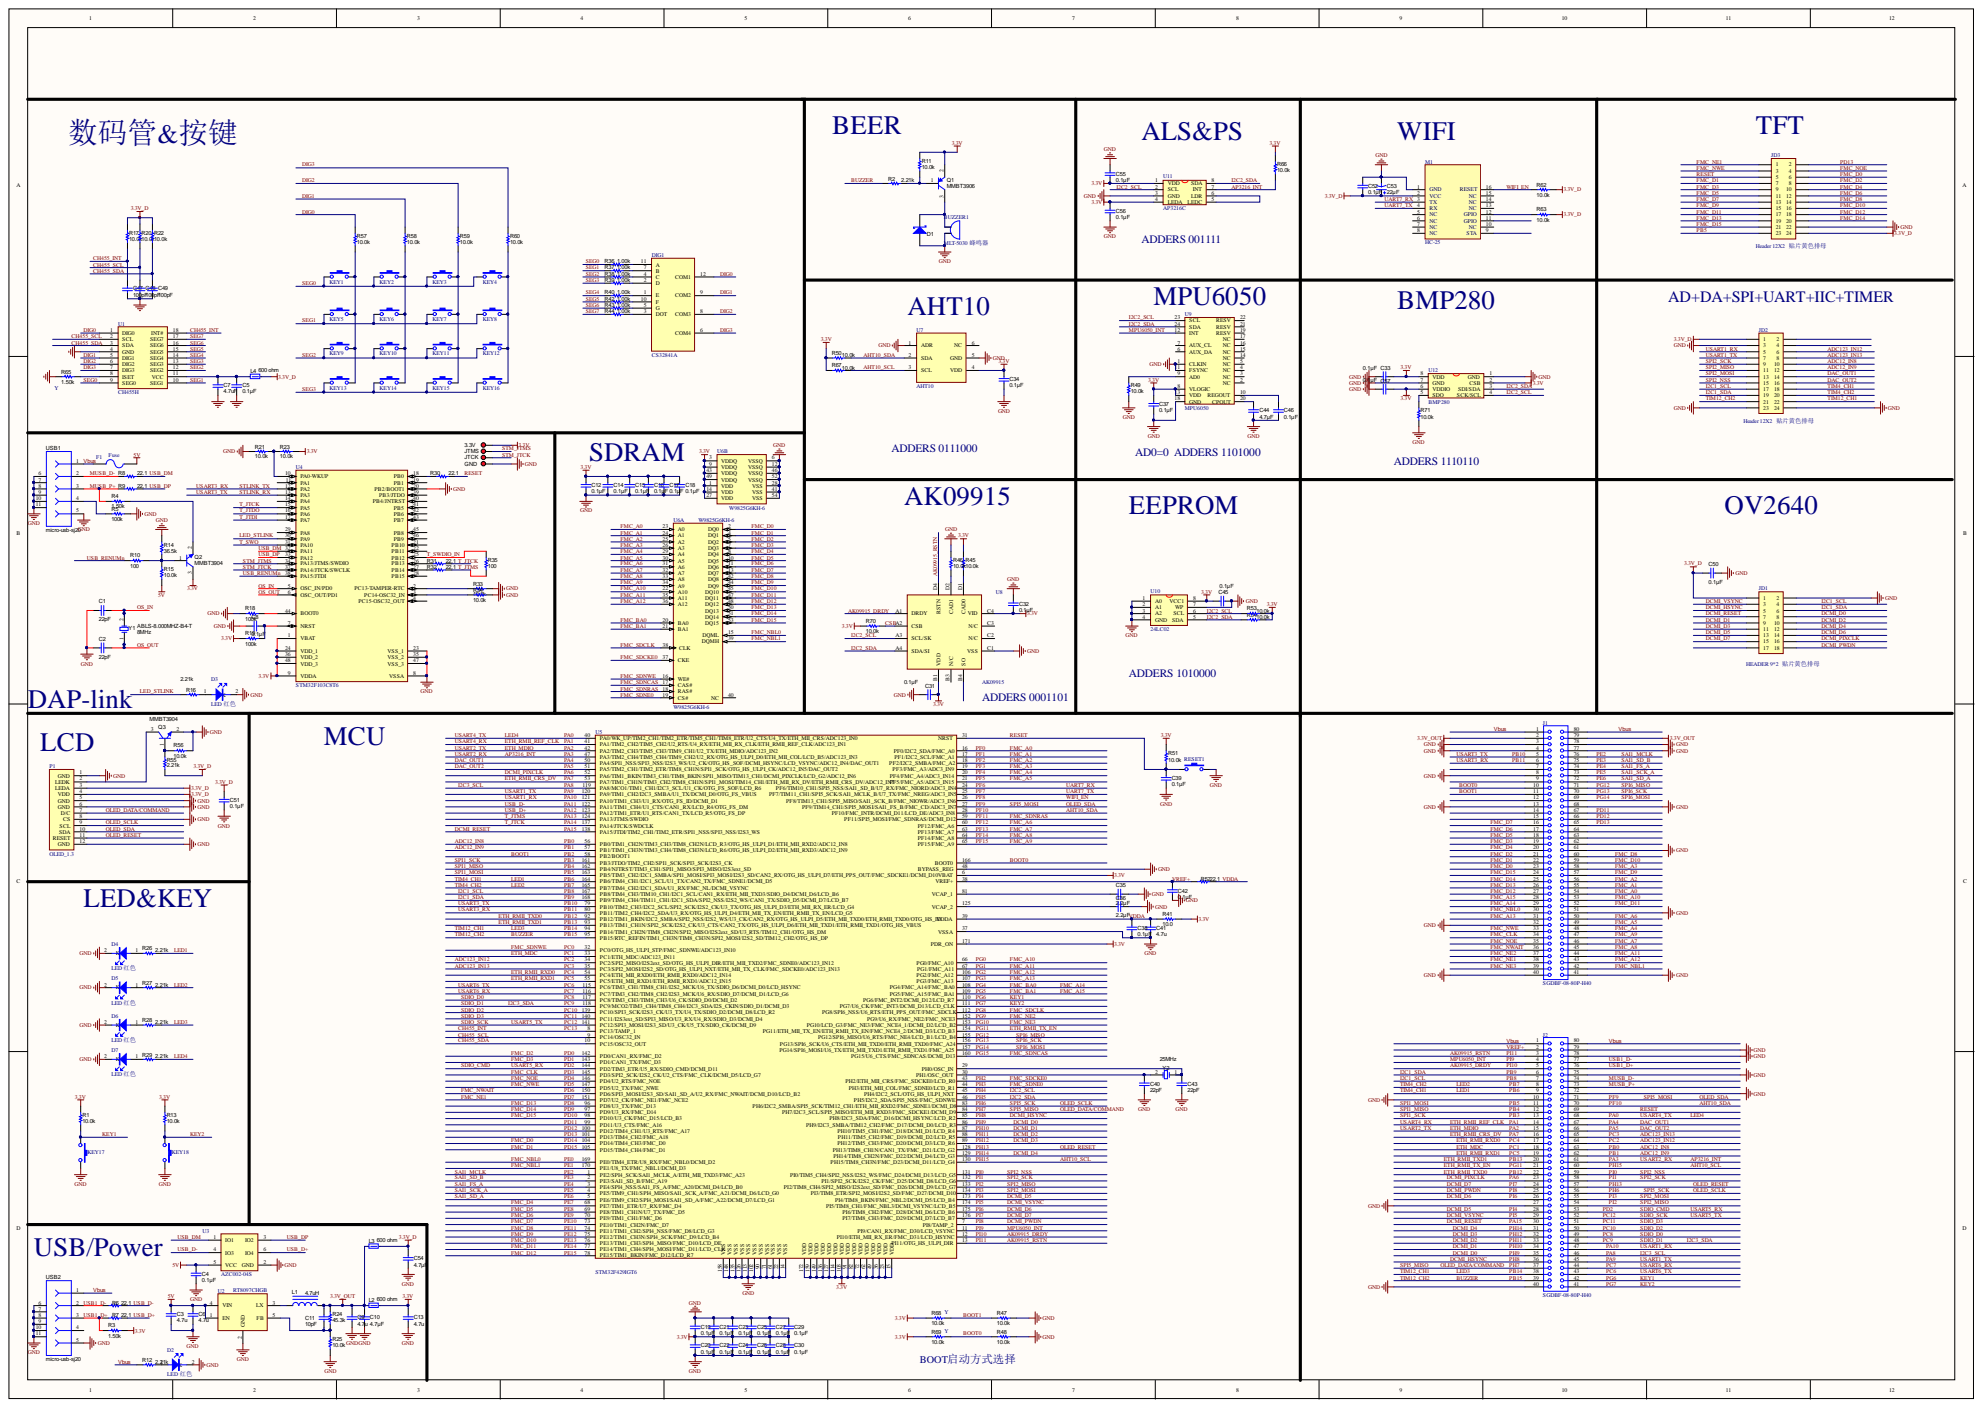
[picture p89: page 1]

AD+DA+SPI+UART+IIC+TIMER
