Kevin-Pal/ECG-Based-Portable-Heart-Rate-Measurement-and-Alarm-Device/(list of files, drawings)

Other design files:
Design of 1st Stage/project/Multisim Simulation File.ms14
